suhui12334/army_manipulator/src/army_manipulator_description/meshes/collision/cam_d435.stl

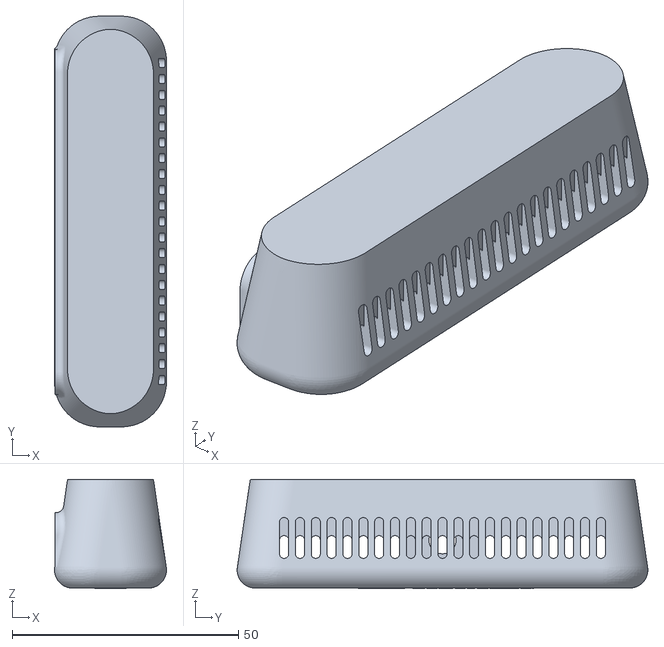
[picture p1: CAD file, 2026-09-10]
src/army_manipulator_description/meshes/collision/cam_d435.stl
24.7 x 90.7 x 24.1
