suhui12334/army_manipulator/src/army_manipulator_description/meshes/visual/rack_right.stl

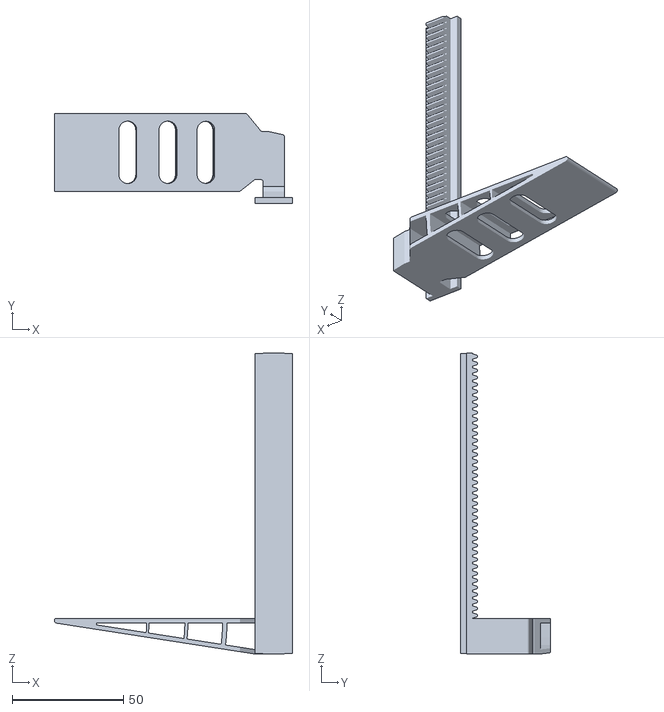
[picture p2: CAD file, 2026-09-10]
src/army_manipulator_description/meshes/visual/rack_right.stl
107.0 x 40.6 x 135.1
