suhui12334/army_manipulator/src/army_manipulator_description/meshes/collision/base_link.stl

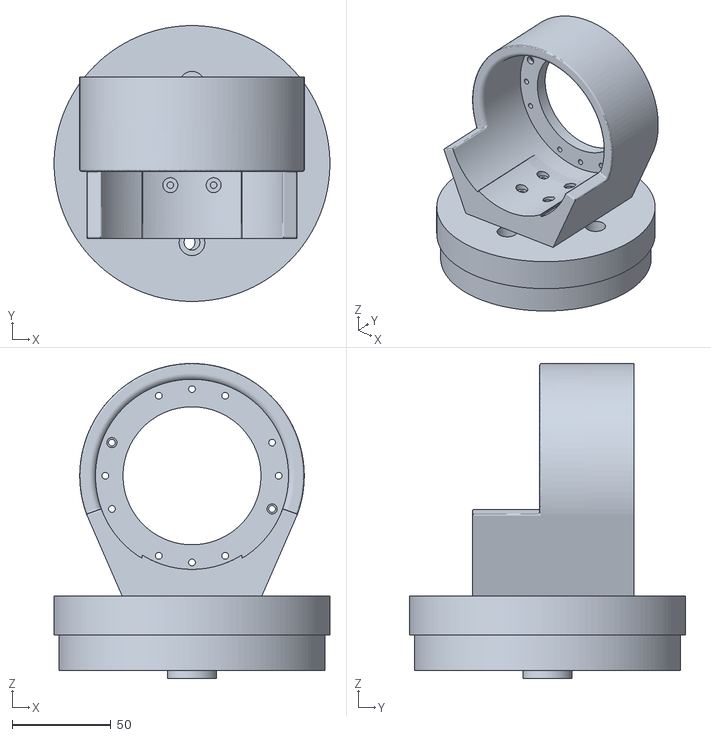
[picture p3: CAD file, 2026-09-10]
src/army_manipulator_description/meshes/collision/base_link.stl
140.0 x 140.0 x 159.9
