suhui12334/army_manipulator/src/army_manipulator_description/meshes/visual/wrist_actuator.stl

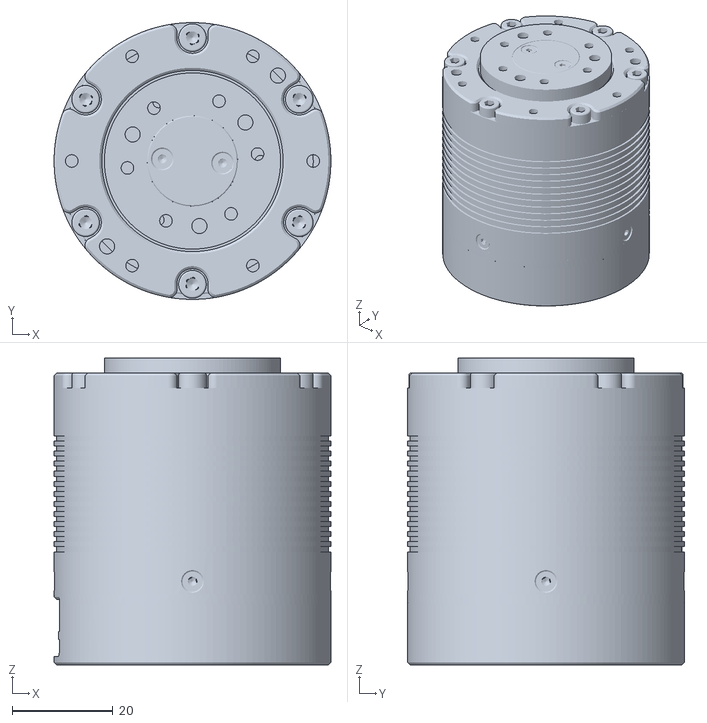
[picture p4: CAD file, 2026-09-10]
src/army_manipulator_description/meshes/visual/wrist_actuator.stl
55.0 x 55.0 x 61.0
