suhui12334/army_manipulator/src/army_manipulator_description/meshes/collision/shoulder_actuator.stl

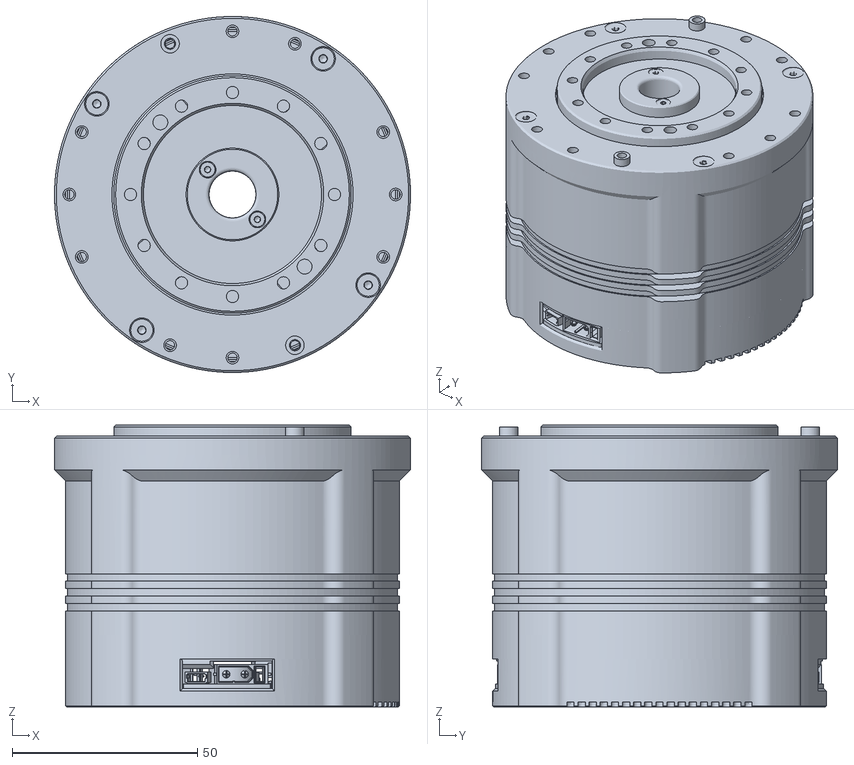
[picture p5: CAD file, 2026-09-10]
src/army_manipulator_description/meshes/collision/shoulder_actuator.stl
96.0 x 96.0 x 76.0
