suhui12334/army_manipulator/src/army_manipulator_description/meshes/visual/elbow_link.stl

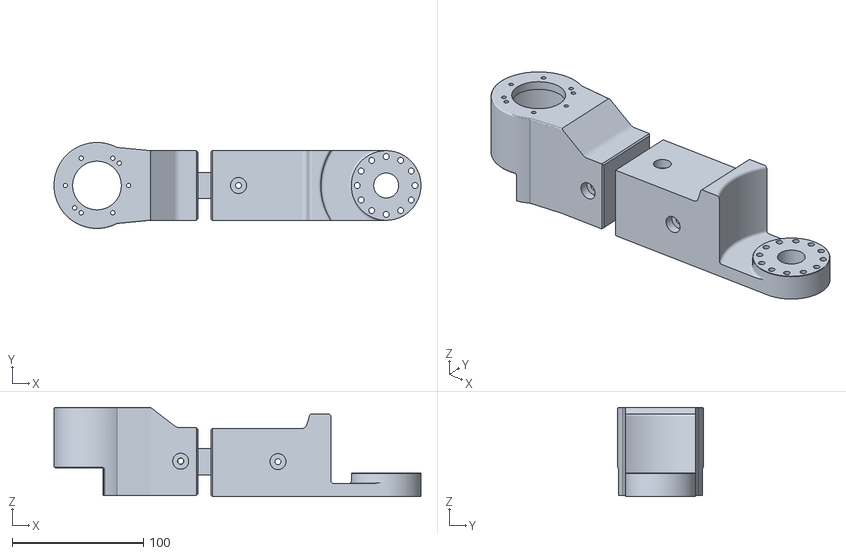
[picture p6: CAD file, 2026-09-10]
src/army_manipulator_description/meshes/visual/elbow_link.stl
279.2 x 65.4 x 68.0
