suhui12334/army_manipulator/src/army_manipulator_description/meshes/visual/elbow_actuator.stl

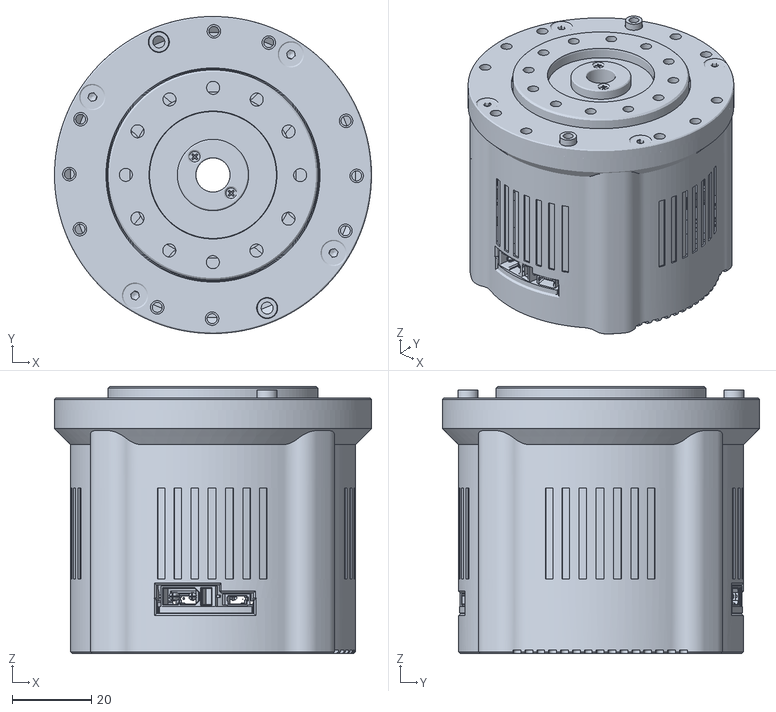
[picture p7: CAD file, 2026-09-10]
src/army_manipulator_description/meshes/visual/elbow_actuator.stl
80.0 x 80.0 x 67.5
