suhui12334/army_manipulator/src/army_manipulator_description/meshes/collision/gripper_actuator.stl

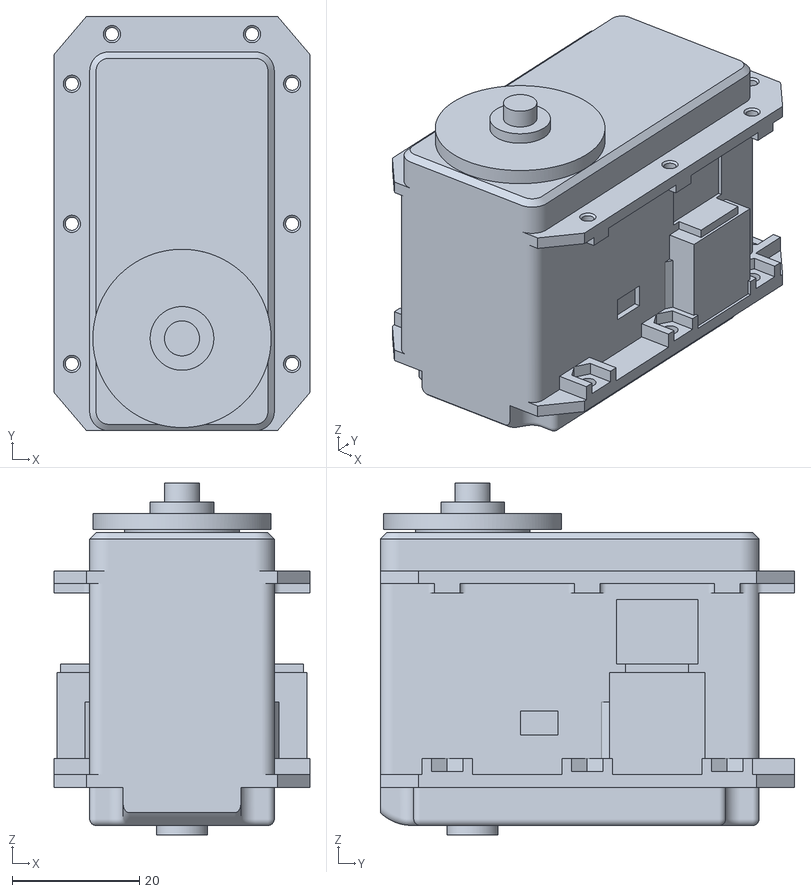
[picture p8: CAD file, 2026-09-10]
src/army_manipulator_description/meshes/collision/gripper_actuator.stl
40.2 x 65.1 x 55.3
