suhui12334/army_manipulator/src/army_manipulator_description/meshes/visual/base_actuator.stl

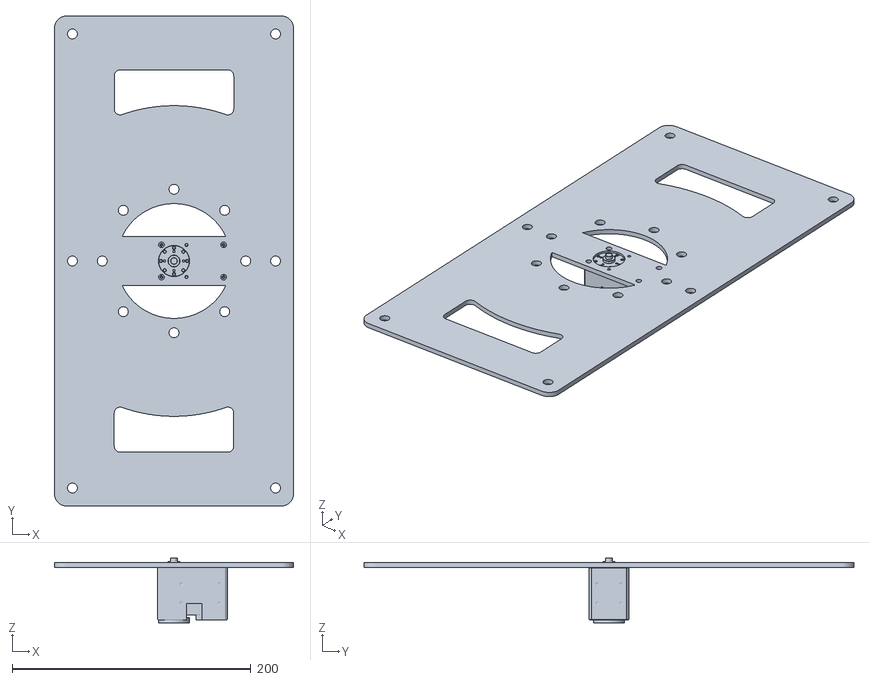
[picture p9: CAD file, 2026-09-10]
src/army_manipulator_description/meshes/visual/base_actuator.stl
200.0 x 410.0 x 54.3
