suhui12334/army_manipulator/src/army_manipulator_description/meshes/collision/wrist_link.stl

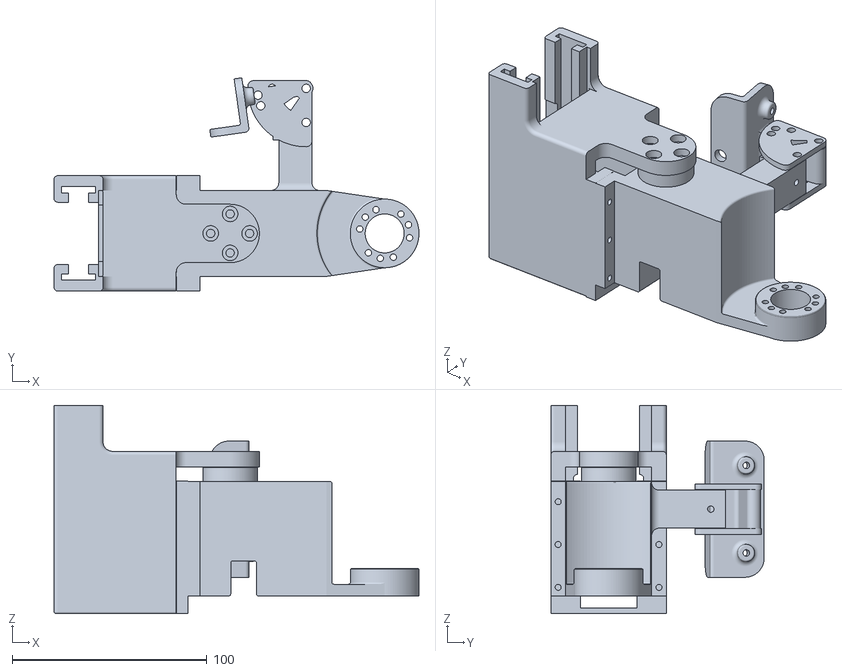
[picture p10: CAD file, 2026-09-10]
src/army_manipulator_description/meshes/collision/wrist_link.stl
187.5 x 109.7 x 107.0
