suhui12334/army_manipulator/src/army_manipulator_description/meshes/visual/rack_left.stl

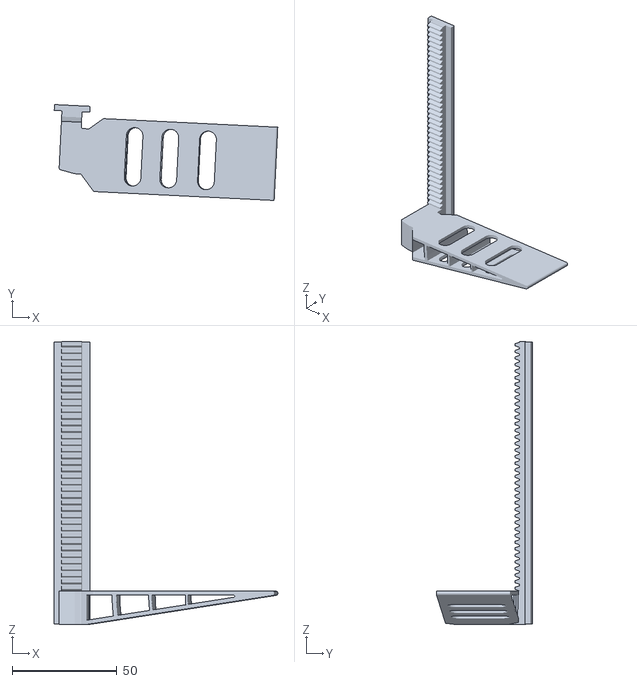
[picture p11: CAD file, 2026-09-10]
src/army_manipulator_description/meshes/visual/rack_left.stl
106.7 x 45.8 x 135.1
