suhui12334/army_manipulator/src/army_manipulator_description/meshes/collision/shoulder_link.stl

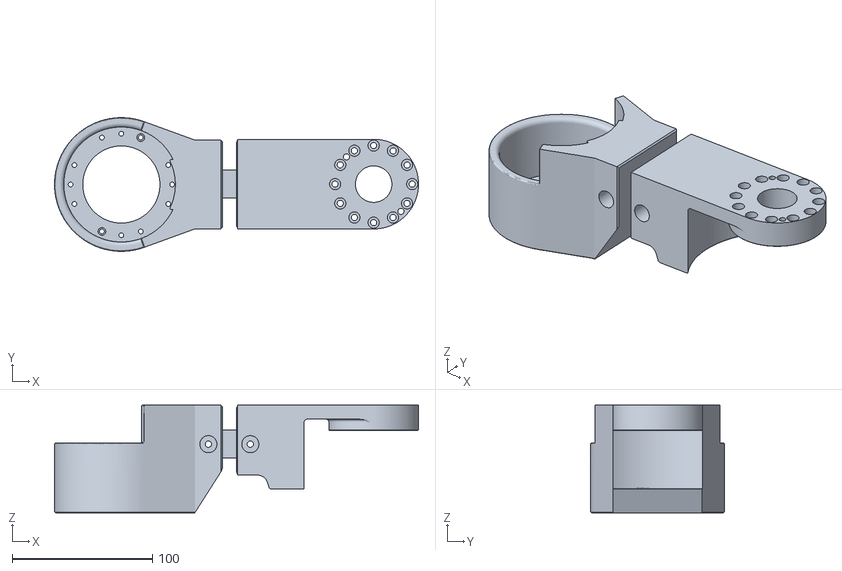
[picture p12: CAD file, 2026-09-10]
src/army_manipulator_description/meshes/collision/shoulder_link.stl
259.7 x 95.4 x 76.9
