suhui12334/army_manipulator/src/army_manipulator_description/meshes/collision/cam_d455.stl

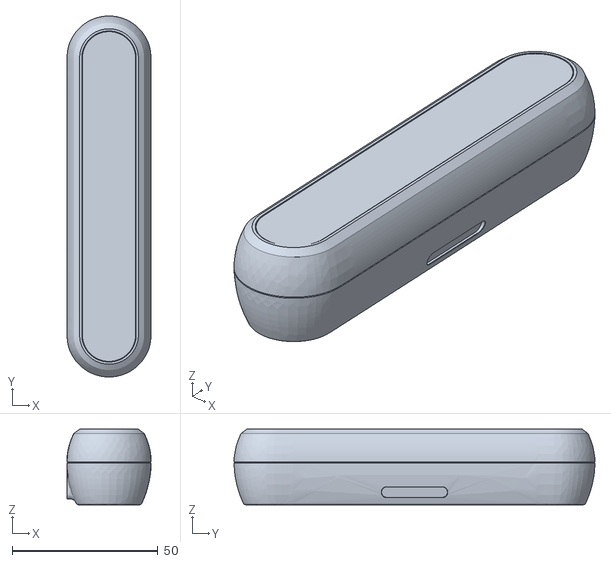
[picture p13: CAD file, 2026-09-10]
src/army_manipulator_description/meshes/collision/cam_d455.stl
29.0 x 124.0 x 26.0
