suhui12334/army_manipulator/src/army_manipulator_description/meshes/collision/pinion_gear.stl

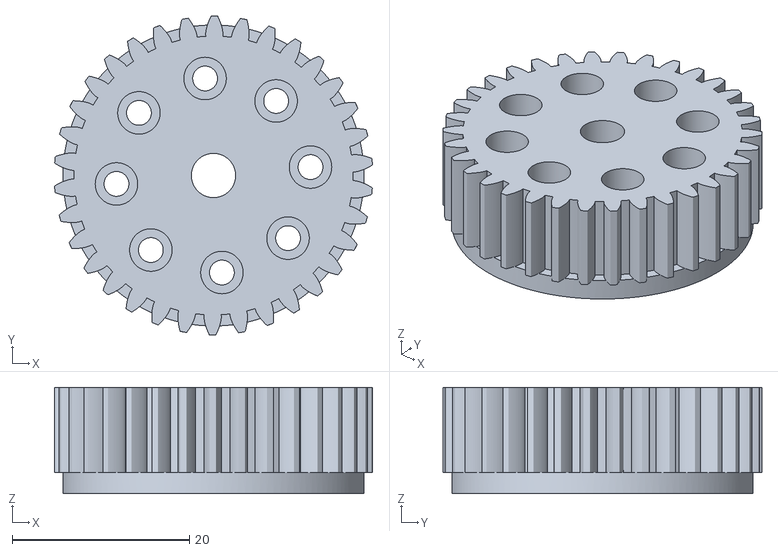
[picture p14: CAD file, 2026-09-10]
src/army_manipulator_description/meshes/collision/pinion_gear.stl
35.9 x 36.0 x 12.0
