suhui12334/army_manipulator/src/army_manipulator_description/meshes/collision/cam_link.stl

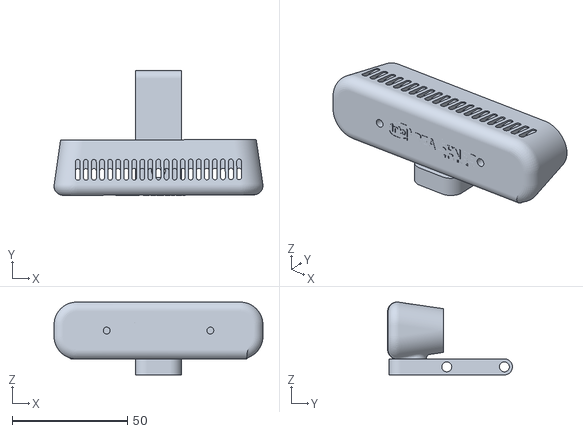
[picture p15: CAD file, 2026-07-16]
src/army_manipulator_description/meshes/collision/cam_link.stl
90.7 x 54.2 x 31.6
