suhui12334/army_manipulator/src/army_manipulator_moveit_config/config/joint_limits.yaml

# joint_limits.yaml allows the dynamics properties specified in the URDF to be overwritten or augmented as needed
#
# For beginners, we downscale velocity and acceleration limits.
# You can always specify higher scaling factors (<= 1.0) in your motion requests.
# Increase the values below to 1.0 to always move at maximum speed.
default_velocity_scaling_factor: 0.1
default_acceleration_scaling_factor: 0.1

# Specific joint properties can be changed with the keys [max_position, min_position, max_velocity, max_acceleration]
# Joint limits can be turned off with [has_velocity_limits, has_acceleration_limits]
# [수정] Setup Assistant가 has_acceleration_limits를 전부 false로 생성했었다 -
# 가속도 리미트는 실측 전 임시값(속도 리미트와 동일값 사용)이라도 켜두는 게
# 궤적 타임 파라미터라이제이션에 필요해서 복원했다.
joint_limits:
  base_joint:
    has_velocity_limits: true
    max_velocity: 2.618
    has_acceleration_limits: true
    max_acceleration: 2.618
  shoulder_joint:
    has_velocity_limits: true
    max_velocity: 1.047
    has_acceleration_limits: true
    max_acceleration: 1.047
  elbow_joint:
    has_velocity_limits: true
    max_velocity: 1.571
    has_acceleration_limits: true
    max_acceleration: 1.571
  wrist_joint:
    has_velocity_limits: true
    max_velocity: 2.618
    has_acceleration_limits: true
    max_acceleration: 2.618
  gripper_joint:
    has_velocity_limits: true
    max_velocity: 3.665
    has_acceleration_limits: true
    max_acceleration: 3.665
