suhui12334/army_manipulator/(commit log)

2026-07-09 Add army_manipulator ROS2 package skeleton (description/moveit_config/bringup)
    MARU 4DoF+gripper arm URDF converted to XACRO, mock/real ros2_control
    hardware branches, hand-authored MoveIt2 SRDF/config for immediate
    RViz+MoveIt2 mock verification, and MoveIt Setup Assistant launch.
    [army_manipulator.urdf.xacro, army_manipulator_macro.xacro, army_manipulator_ros2_control.xacro, joint_limits.yaml, materials.xacro, ros2_controllers.yaml]
2026-07-09 Fix joint offset values in README.md
    Updated offset values for shoulder, elbow, and wrist joints in the hardware specifications.
2026-07-09 Update Case C joint offsets to match latest motor spec
    shoulder_lift: -55mm -> -37.7mm, elbow: +35mm -> +18.8mm, wrist: -25mm -> -31.3mm
    (gripper offset unchanged). Re-verified xacro rendering for both mock and
    real hardware branches.
    [army_manipulator_macro.xacro]
2026-07-09 Fix move_group/moveit_rviz launch: point robot_description at description pkg
    MoveItConfigsBuilder's default robot_description path guess is
    <package_name>/config/<robot_name>.urdf.xacro, but the URDF actually
    lives in army_manipulator_description. The unresolved default was
    surfacing as a bogus "executable not found on PATH" launch error.
2026-07-13 Change communication protocol for base joint to TTL
2026-07-16 Reorganize into src/ colcon layout; add joint zero-offset calibration
    - Move all packages under src/ following standard colcon workspace
    layout; ignore build/install/log artifacts.
    - Wire maru_ik_node into mock_bringup.launch.py, add
    target_detector_node.py/realsense_bringup.launch.py, update CAN
    bus/actuator IDs, add use_mesh xacro arg (carried over from prior
    uncommitted work in the moved tree).
    - Add army_manipulator_description/config/joint_calibration.yaml as
    the single source of truth for per-joint raw encoder limits and
    zero_offset (placeholder 0.0 until measured).
    - army_manipulator_macro.xacro now loads that yaml via xacro.load_yaml
    and computes actual_limit = raw_limi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
    [army_manipulator.urdf.xacro, army_manipulator_macro.xacro, army_manipulator_ros2_control.xacro, joint_calibration.yaml, joint_limits.yaml, materials.xacro, ros2_controllers.yaml]
2026-07-16 Integrate real STL meshes, restructure gripper as rack-pinion, fix camera TF parent bug
    [army_manipulator_macro.xacro, base_actuator.stl, base_link.stl, cam_link.stl, elbow_link.stl, lack_left.stl, lack_right.stl, pinion_gear.stl]
2026-07-21 WIP: rack-pinion gripper 관련 설정 및 launch 파일 정리
    [army_manipulator.ros2_control.xacro, army_manipulator.urdf.xacro, army_manipulator_macro.xacro, army_manipulator_ros2_control.xacro, base_actuator.stl, base_link.stl, joint_calibration.yaml, joint_limits.yaml]
2026-08-08 feat: add D455 supplybox grasp pipeline
    [army_manipulator.urdf.xacro, army_manipulator_macro.xacro, army_manipulator_ros2_control.xacro]
2026-08-13 docs: document D455 to CAN bringup flow
2026-08-13 feat: add revised ros2 control xacro
    [army_manipulator_macro.xacro, army_manipulator_ros2_control2.xacro]
2026-09-10 Sync arm packages from dolbotZ
    [army_manipulator.ros2_control.xacro, army_manipulator.urdf.xacro, army_manipulator_macro.xacro, army_manipulator_ros2_control.xacro, army_manipulator_ros2_control2.xacro, base_actuator.stl, base_link.stl, cam_d435.stl]
